etxmsol/ThermoShield/LoggerShieldDefect.jpg

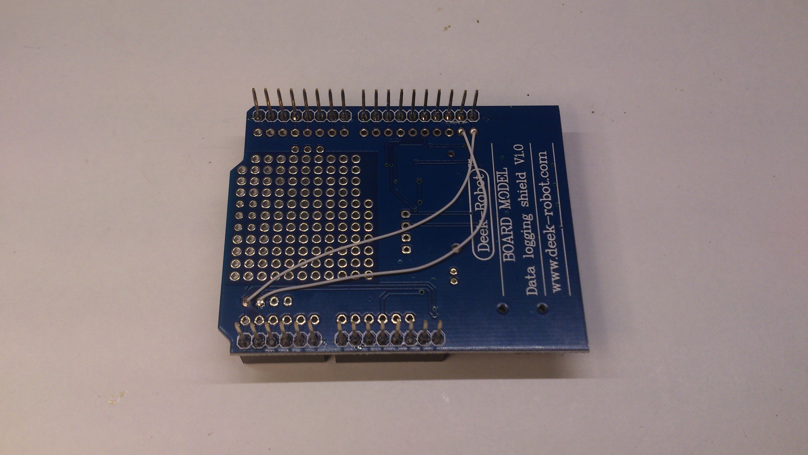
LoggerShieldDefect.jpg
