etxmsol/ThermoShield/conditioning.asc

C1: cap; 10nf
R3: res; 10k
U1: LT1013A
V1: voltage; 5
V2: voltage; ""; AC 10mv
V3: voltage; -5
Named nets: 0, +5, out, -5
;tran 1000
.ac dec 20 1Hz 1000KHz
