etxmsol/ThermoShield/Draft5.asc

R1: res; 10k
R2: res; 5k
U1: LT1022
V1: voltage; SINE(0 10mv 10k); AC 10mv; Rser=1meg Cpar=400pF
V2: voltage; -12
V3: voltage; +12
Named nets: 0, +Vdd, -Vcc, out
.tran 10ms
