etxmsol/ThermoShield/spice_simulation.asc

R1: res; {THERM}
R2: res; {r1}
V1: voltage; 5
Named nets: 0, opamp
.param THERM=100k*exp( 3950/(temp+273) - 3950/(25+273) )
.step temp -30 50 1
.op
.step param r1 list 5000 10000 100000 200000
