etxmsol/ThermoShield/v2.1/ThermoActuator.brd

## EAGLE design v2.1/ThermoActuator.brd (2016-06-04)

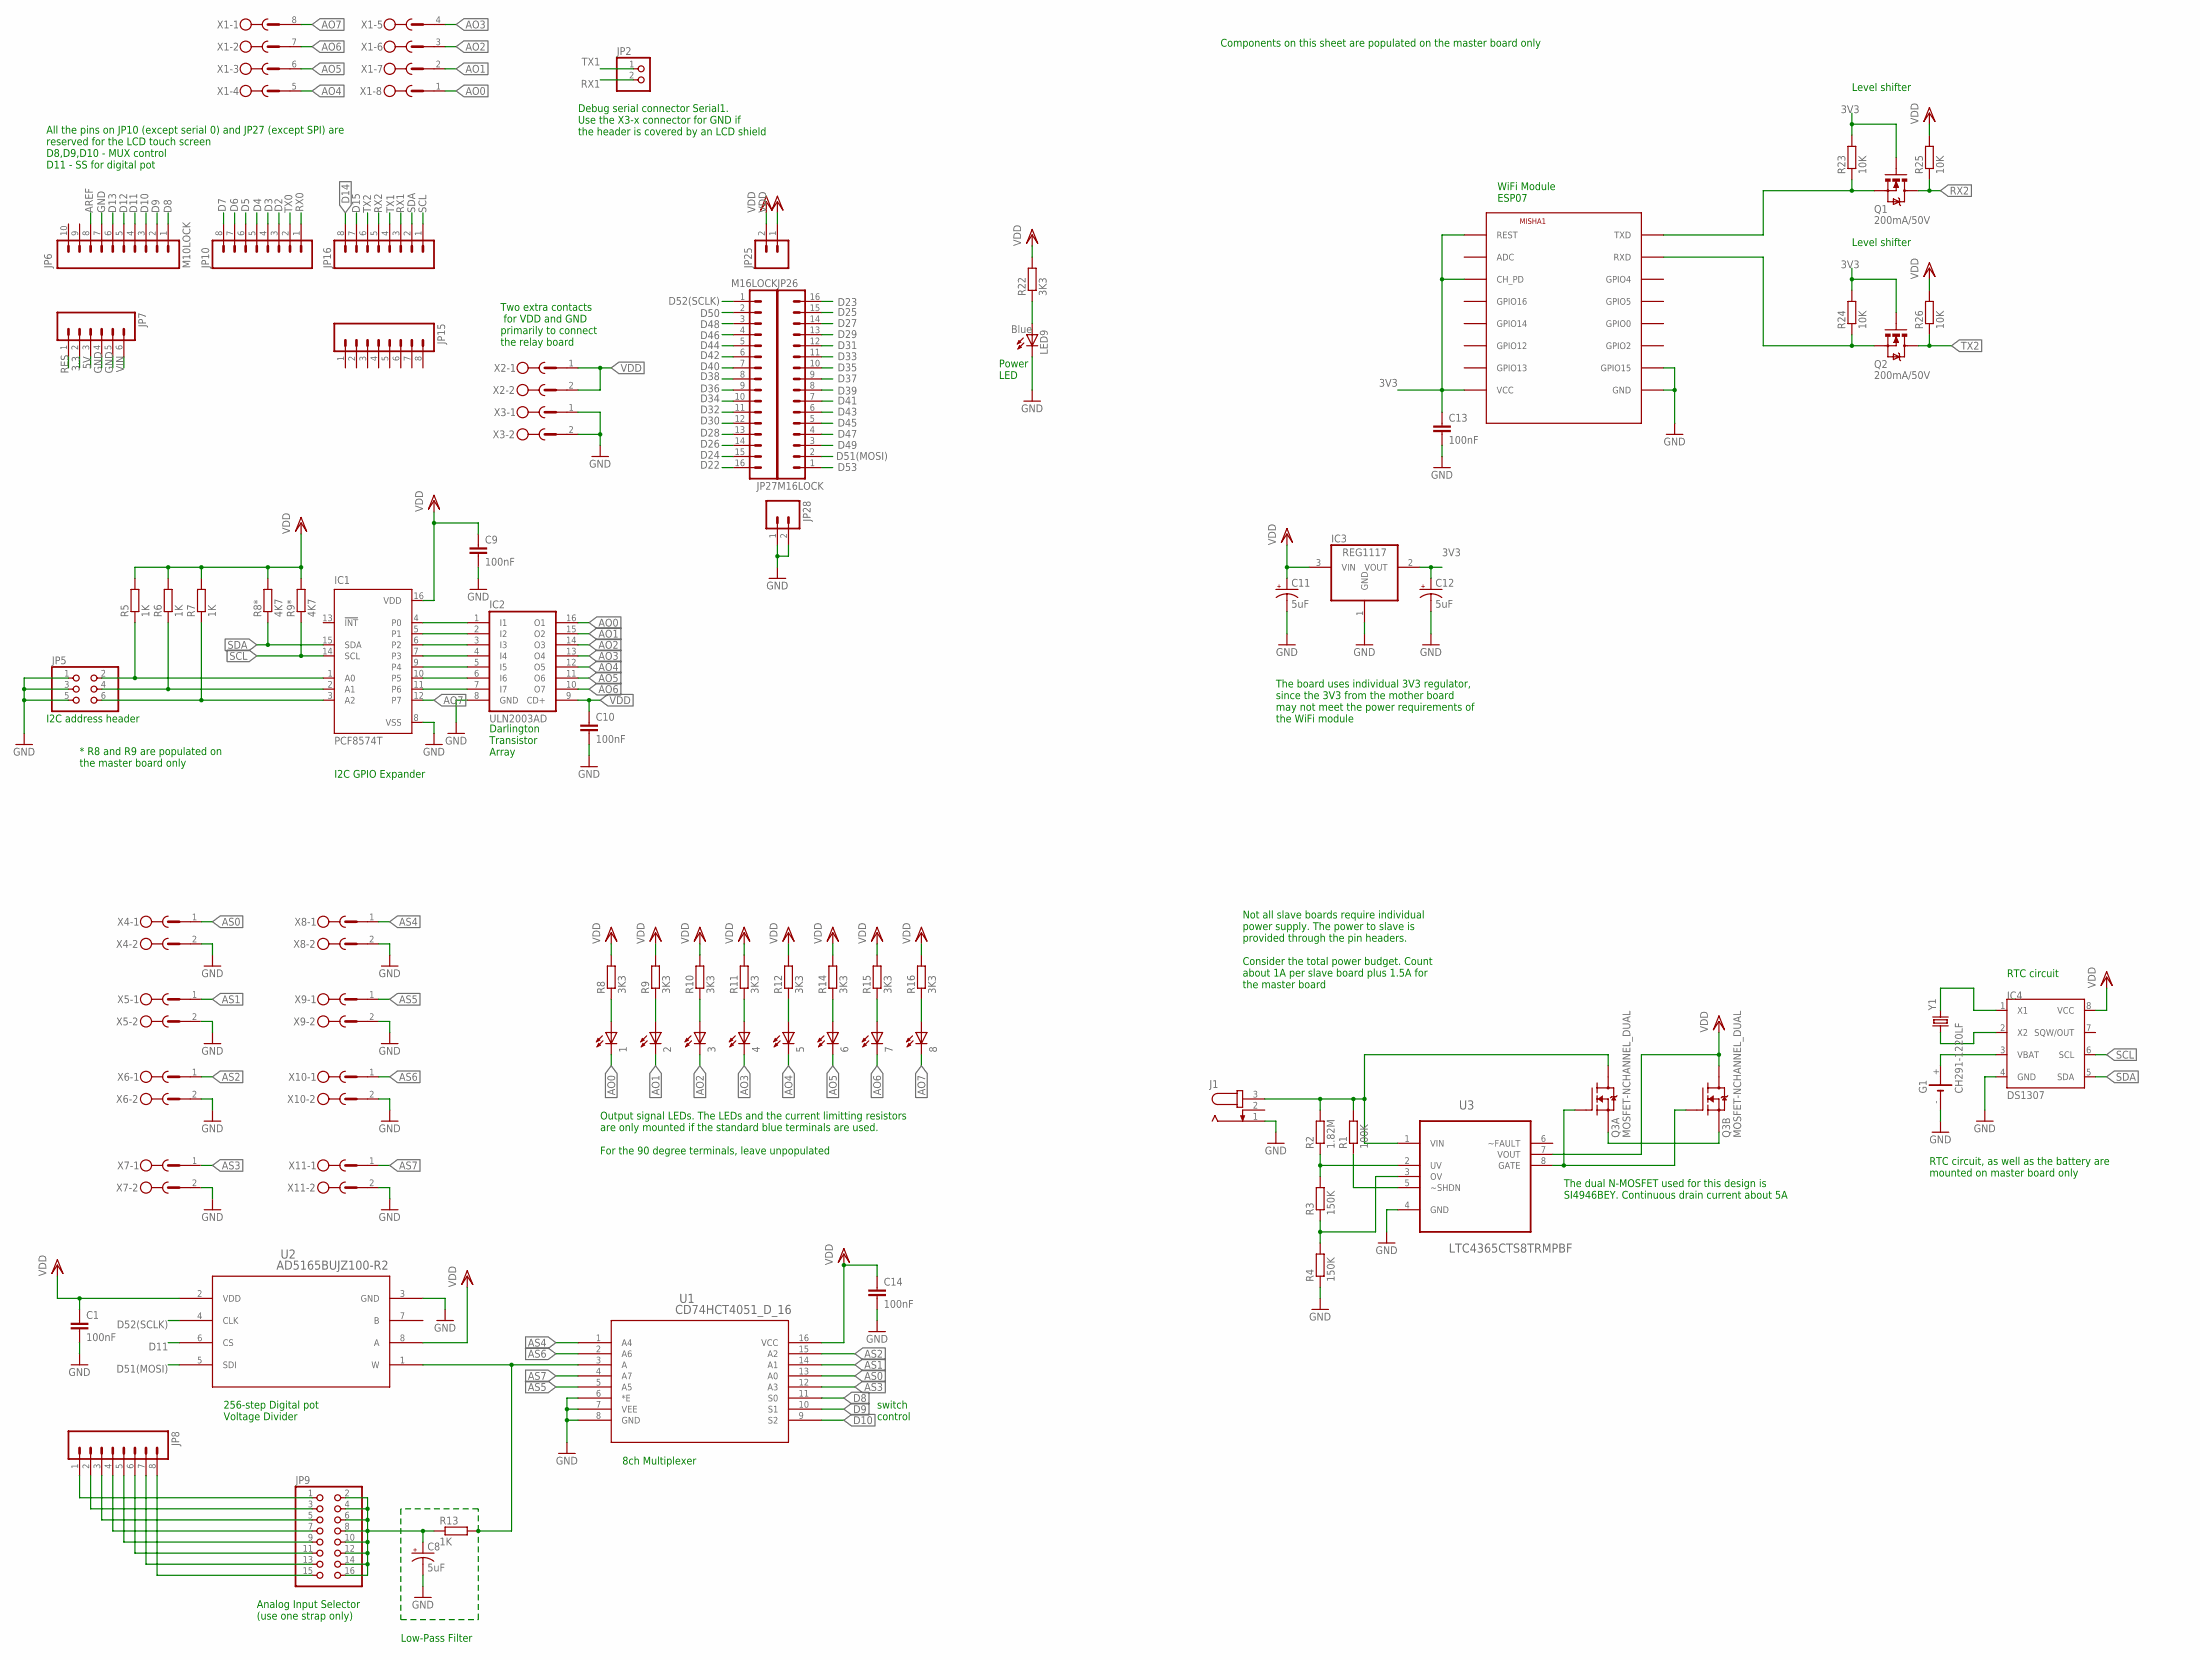
[picture p2: schematic ThermoActuator.sch]

Parts:
1, 2, 3, 4, 5, 6, 7, 8: LEDCHIP-LED0805; CHIP-LED0805
C1, C9, C10, C13, C14: 100nF; C0805
C8, C11, C12: 5uF; EIA3216
G1: CH291-1220LF
IC1: PCF8574T; SO16W
IC2: ULN2003AD; SO16
IC3: REG1117; SOT223
IC4: DS1307; SOIC-8
J1: JACK-PLUG1; SPC4078
JP2: PINHD-1X2; 1X02
JP5: PINHD-2X3; 2X03
JP6: M10LOCK; 1X10_LOCK
JP7: M06LOCK; 1X06_LOCK
JP8, JP10, JP15, JP16: M08LOCK; 1X08_LOCK
JP9: PINHD-2X8; 2X08
JP25, JP28: M02LOCK; 1X02_LOCK
JP26, JP27: M16LOCK; 1X16_LOCK
LED9: Blue; CHIP-LED0805
MISHA1: ESP8266-07; ESP-07
Q1, Q2: 200mA/50V; SOT23-3
Q3: MOSFET-NCHANNEL_DUAL; SO08
R1: 100K; R0805
R2: 1.82M; R0805
R3, R4: 150K; R0805
R5, R6, R7: 1K; R0805
R8, R9, R10, R11, R12, R14, R15, R16, R22: 3K3; R0805
R8*, R9*: 4K7; R0805
R13: 1K; R1206
R23, R24, R25, R26: 10K; R0805
U1: CD74HCT4051_D_16; D16
U2: AD5165BUJZ100-R2; UJ_8
U3: LTC4365CTS8TRMPBF; SOT65P280X100-8N
X1: MSTBV8
X2, X3, X4, X5, X6, X7, X8, X9, X10, X11: MSTBV2
Y1: CRYSTAL3.2X1.5MM; CRYSTAL-SMD-3.2X1.5MM

Connections:
3.3: JP7.2
3V3: C12.A (+), C13.1, IC3.2 (VOUT), MISHA1.CH_PD, MISHA1.REST, MISHA1.VCC, Q1.1 (G), Q2.1 (G), R23.2, R24.2
5V: JP7.3
AO0: 1.C, IC2.16 (O1), X1.1
AO1: 2.C, IC2.15 (O2), X1.2
AO2: 3.C, IC2.14 (O3), X1.3
AO3: 4.C, IC2.13 (O4), X1.4
AO4: 5.C, IC2.12 (O5), X1.5
AO5: 6.C, IC2.11 (O6), X1.6
AO6: 7.C, IC2.10 (O7), X1.7
AO7: 8.C, IC1.12 (P7), X1.8
AREF: JP6.8
AS0: U1.13 (A0), X4.1
AS1: U1.14 (A1), X5.1
AS2: U1.15 (A2), X6.1
AS3: U1.12 (A3), X7.1
AS4: U1.1 (A4), X8.1
AS5: U1.5 (A5), X9.1
AS6: U1.2 (A6), X10.1
AS7: U1.4 (A7), X11.1
D2: JP10.3
D3: JP10.4
D4: JP10.5
D5: JP10.6
D6: JP10.7
D7: JP10.8
D8: JP6.1, U1.11 (S0)
D9: JP6.2, U1.10 (S1)
D10: JP6.3, U1.9 (S2)
D11: JP6.4, U2.6 (CS)
D12: JP6.5
D13: JP6.6
D14: JP16.8
D15: JP16.7
D22: JP27.16
D23: JP26.16
D24: JP27.15
D25: JP26.15
D26: JP27.14
D27: JP26.14
D28: JP27.13
D29: JP26.13
D30: JP27.12
D31: JP26.12
D32: JP27.11
D33: JP26.11
D34: JP27.10
D35: JP26.10
D36: JP27.9
D37: JP26.9
D38: JP27.8
D39: JP26.8
D40: JP27.7
D41: JP26.7
D42: JP27.6
D43: JP26.6
D44: JP27.5
D45: JP26.5
D46: JP27.4
D47: JP26.4
D48: JP27.3
D49: JP26.3
D50: JP27.2
D51(MOSI): JP26.2, U2.5 (SDI)
D52(SCLK): JP27.1, U2.4 (CLK)
D53: JP26.1
GND: C1.2, C8.C (-), C9.2, C10.2, C11.C (-), C12.C (-), C13.2, C14.2, G1.-, IC1.8 (VSS), IC2.8 (GND), IC3.1 (GND), IC4.4 (GND), J1.1, JP5.1, JP5.3, JP5.5, JP6.7, JP7.4, JP7.5, JP28.1, JP28.2, LED9.C, MISHA1.GND, MISHA1.GPIO15, R4.1, U1.6 (*E), U1.7 (VEE), U1.8 (GND), U2.3 (GND), U3.4 (GND), X3.1, X3.2, X4.2, X5.2, X6.2, X7.2, X8.2, X9.2, X10.2, X11.2
unnamed: R1.1, U3.5 (~SHDN)
unnamed: R13.2, U1.3 (A), U2.1 (W)
unnamed: IC1.4 (P0), IC2.1 (I1)
unnamed: IC1.5 (P1), IC2.2 (I2)
unnamed: IC1.6 (P2), IC2.3 (I3)
unnamed: IC1.7 (P3), IC2.4 (I4)
unnamed: IC1.9 (P4), IC2.5 (I5)
unnamed: IC1.10 (P5), IC2.6 (I6)
unnamed: IC1.11 (P6), IC2.7 (I7)
unnamed: IC1.1 (A0), JP5.2, R5.1
unnamed: 1.A, R8.1
unnamed: R2.1, R3.2, U3.2 (UV)
unnamed: R3.1, R4.2, U3.3 (OV)
unnamed: Q3.2 (G), Q3.4 (G), U3.8 (GATE)
unnamed: Q3.1 (S), Q3.3 (S)
unnamed: IC4.1 (X1), Y1.P$2 (2)
unnamed: IC4.2 (X2), Y1.P$1 (1)
unnamed: G1.+, IC4.3 (VBAT)
unnamed: 2.A, R9.1
unnamed: IC1.2 (A1), JP5.4, R6.1
unnamed: IC1.3 (A2), JP5.6, R7.1
unnamed: JP8.1, JP9.1
unnamed: JP8.2, JP9.3
unnamed: JP8.3, JP9.5
unnamed: JP8.4, JP9.7
unnamed: JP8.5, JP9.9
unnamed: JP8.6, JP9.11
unnamed: 3.A, R10.1
unnamed: C8.A (+), JP9.2, JP9.4, JP9.6, JP9.8, JP9.10, JP9.12, JP9.14, JP9.16, R13.1
unnamed: JP8.7, JP9.13
unnamed: JP8.8, JP9.15
unnamed: MISHA1.TXD, Q1.2 (S), R23.1
unnamed: MISHA1.RXD, Q2.2 (S), R24.1
unnamed: J1.3, Q3.6 (D1), R1.2, R2.2, U3.1 (VIN)
unnamed: 4.A, R11.1
unnamed: 5.A, R12.1
unnamed: 6.A, R14.1
unnamed: 7.A, R15.1
unnamed: 8.A, R16.1
unnamed: LED9.A, R22.1
RES: JP7.1
RX0: JP10.1
RX1: JP2.2, JP16.3
RX2: JP16.5, Q1.3 (D), R25.1
SCL: IC1.14 (SCL), IC4.6 (SCL), JP16.1, R9*.1
SDA: IC1.15 (SDA), IC4.5 (SDA), JP16.2, R8*.1
TX0: JP10.2
TX1: JP2.1, JP16.4
TX2: JP16.6, Q2.3 (D), R26.1
VDD: C1.1, C9.1, C10.1, C11.A (+), C14.1, IC1.16 (VDD), IC2.9 (CD+), IC3.3 (VIN), IC4.8 (VCC), JP25.1, JP25.2, Q3.8 (D1), R5.2, R6.2, R7.2, R8.2, R8*.2, R9.2, R9*.2, R10.2, R11.2, R12.2, R14.2, R15.2, R16.2, R22.2, R25.2, R26.2, U1.16 (VCC), U2.2 (VDD), U2.8 (A), U3.7 (VOUT), X2.1, X2.2
VIN: JP7.6

Notes on the sheet:
I2C address header
I2C GPIO Expander
Darlington Transistor Array
8ch Multiplexer
Analog Input Selector (use one strap only)
switch control
Level shifter
WiFi Module ESP07
Power LED
The board uses individual 3V3 regulator, since the 3V3 from the mother board may not meet the power requirements of the WiFi module
Components on this sheet are populated on the master board only
* R8 and R9 are populated on the master board only
Not all slave boards require individual power supply. The power to slave is provided through the pin headers. Consider the total power budget. Count about 1A per slave board plus 1.5A for the master board
All the pins on JP10 (except serial 0) and JP27 (except SPI) are reserved for the LCD touch screen D8,D9,D10 - MUX control D11 - SS for digital pot
Low-Pass Filter
Two extra contacts for VDD and GND primarily to connect the relay board
256-step Digital pot Voltage Divider
RTC circuit
The dual N-MOSFET used for this design is SI4946BEY. Continuous drain current about 5A
Debug serial connector Serial1. Use the X3-x connector for GND if the header is covered by an LCD shield
Output signal LEDs. The LEDs and the current limitting resistors are only mounted if the standard blue terminals are used. For the 90 degree terminals, leave unpopulated
RTC circuit, as well as the battery are mounted on master board only

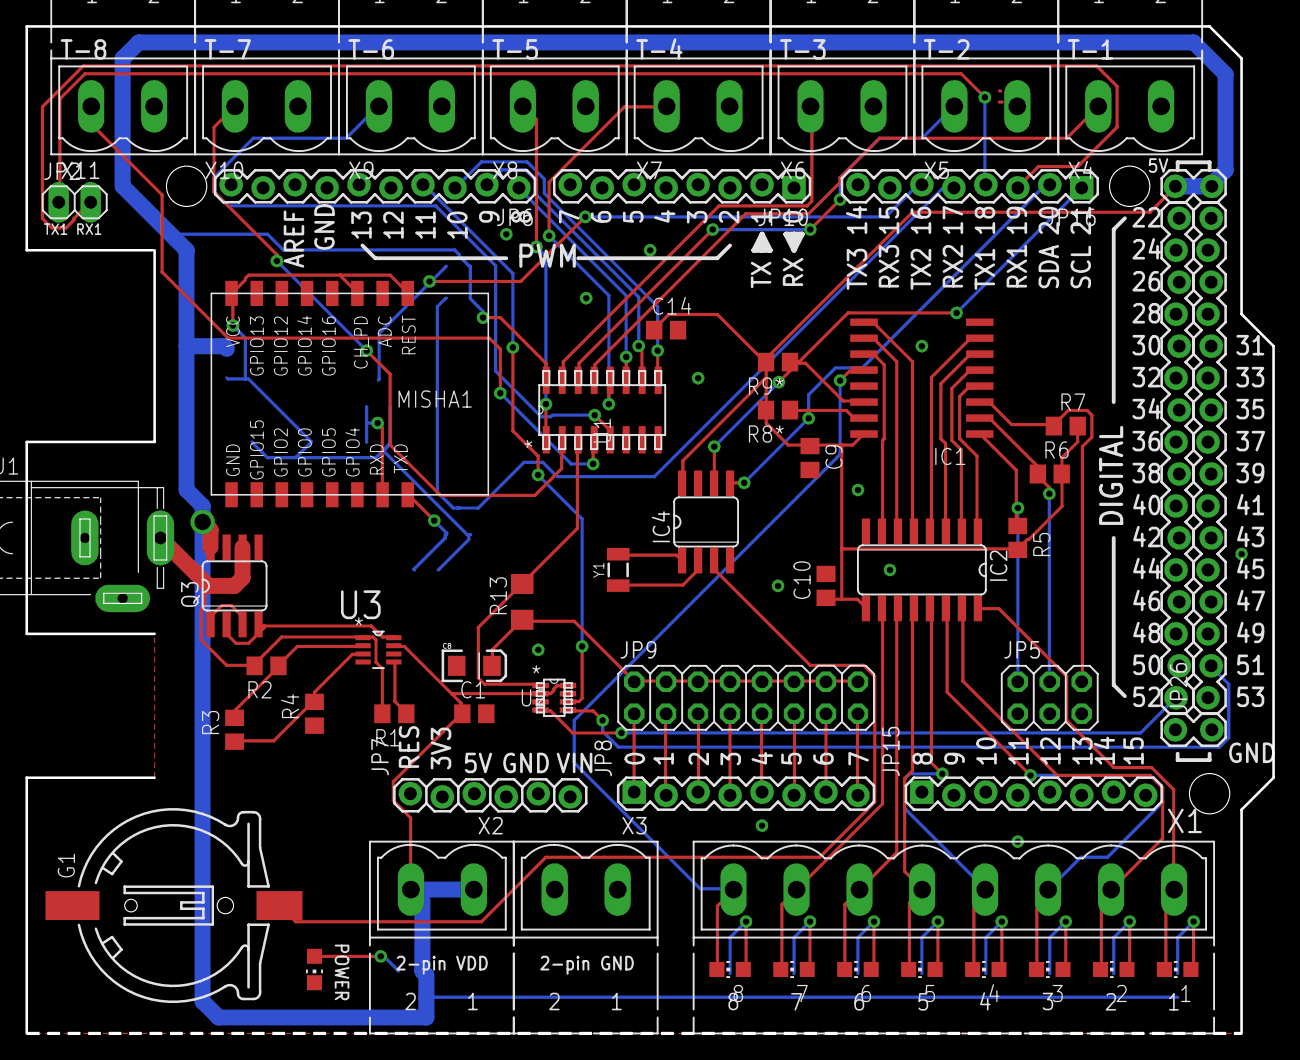
[picture p3: board ThermoActuator.brd from above]

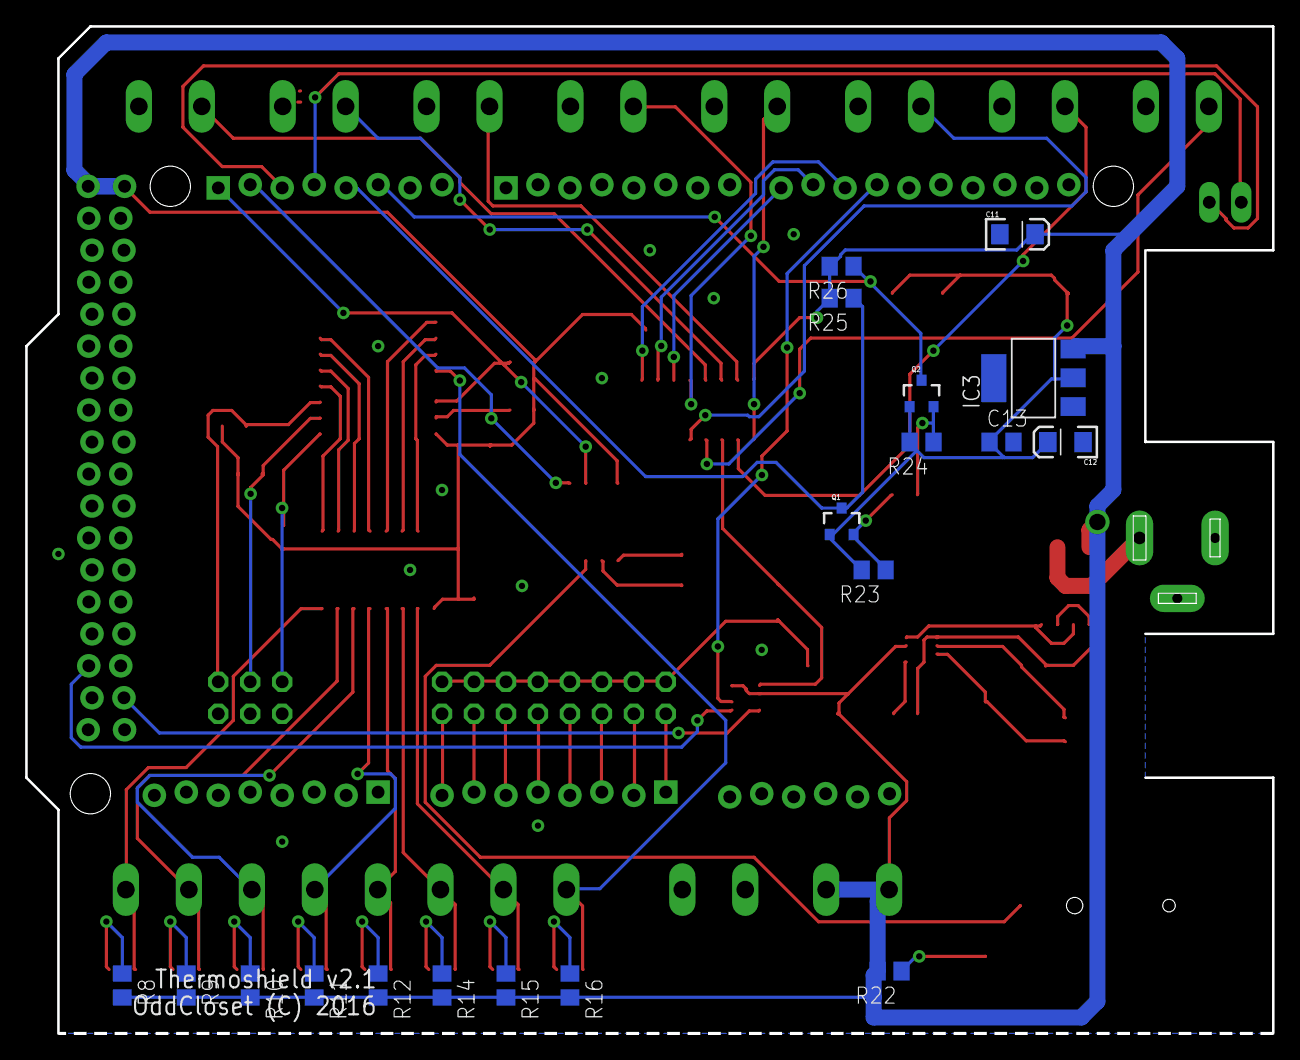
[picture p4: board ThermoActuator.brd from below]

Board: 2 copper layers, 99.1 x 80.0 mm, 78 parts (19 on the bottom side), 71 nets.
