etxmsol/ThermoShield/v1.0/ThermoActuator-v10.brd

## EAGLE design v1.0/ThermoActuator-v10.brd (2015-11-19, an earlier design)

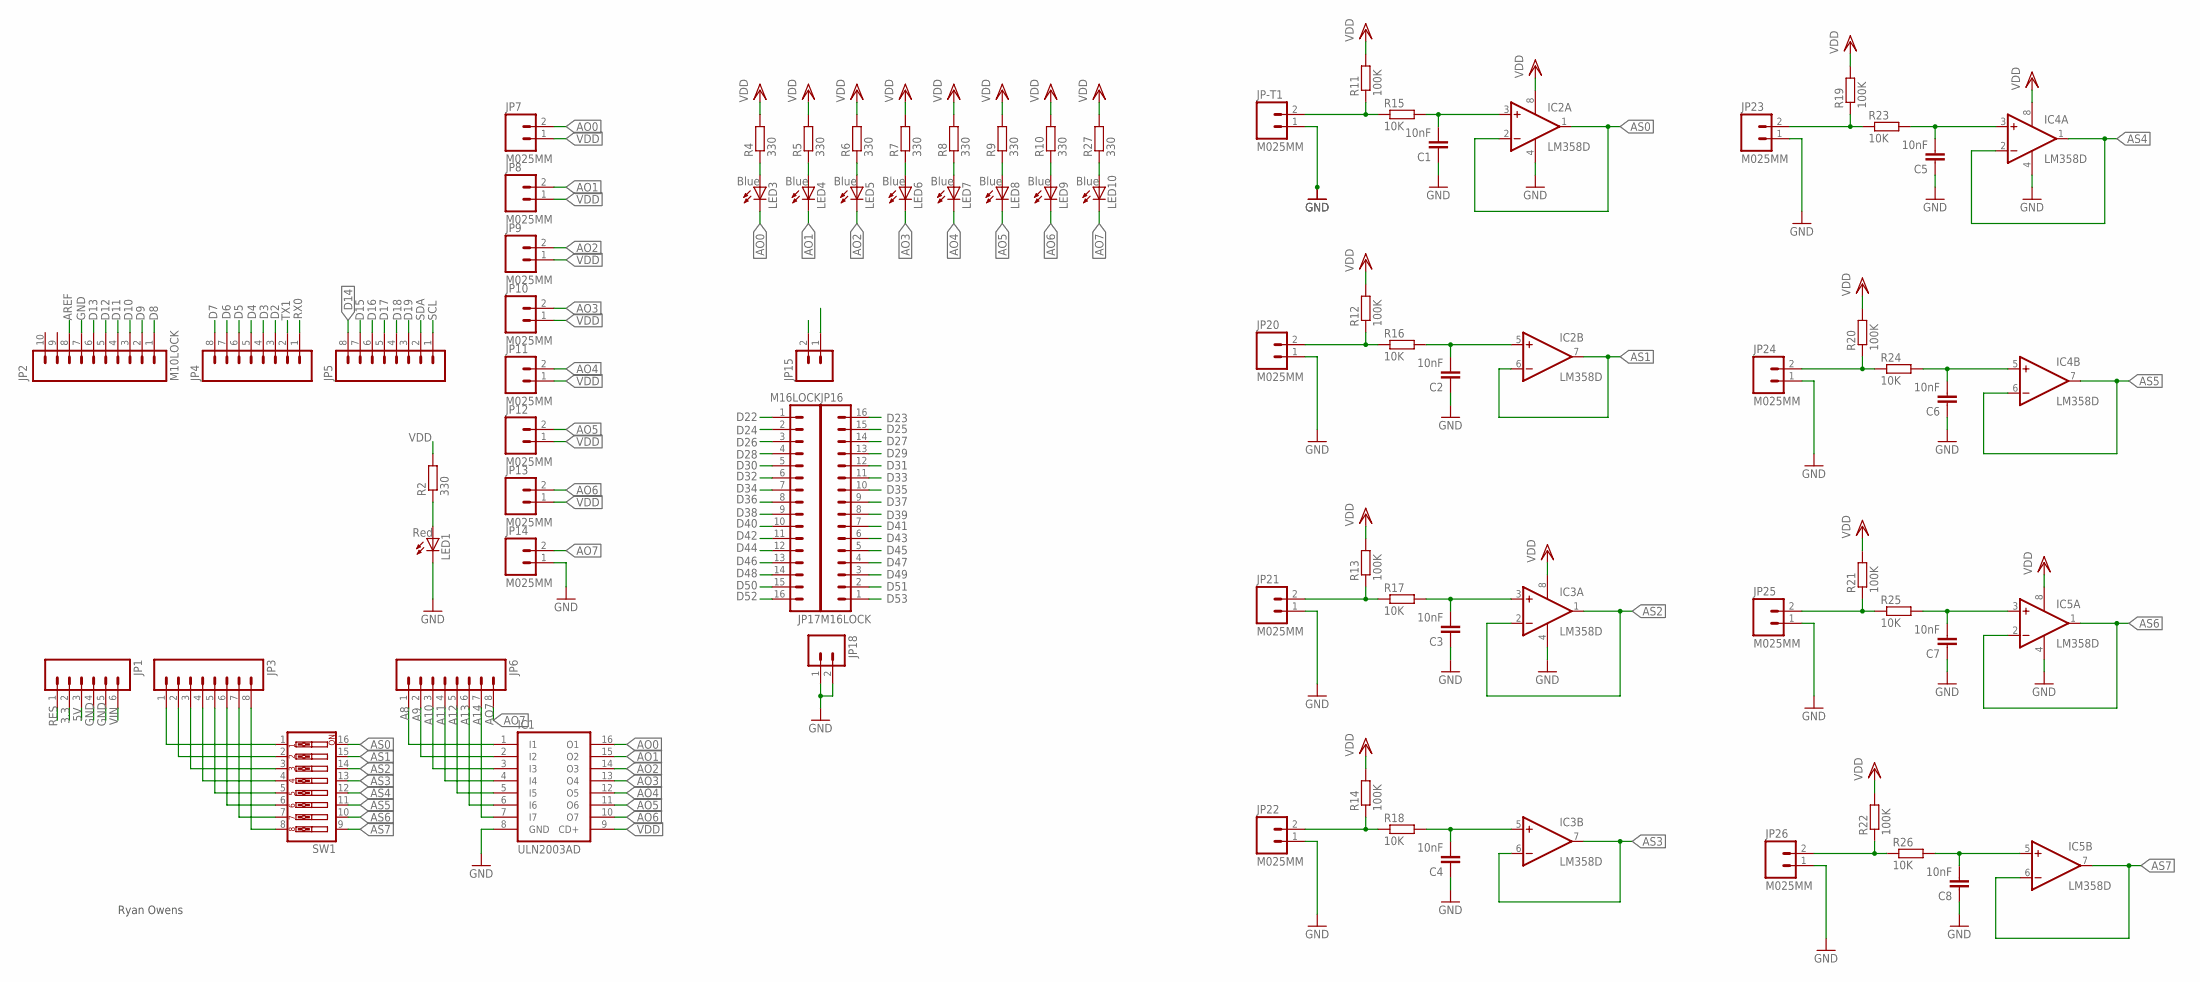
[picture p5: schematic ThermoActuator-v10.sch]

Parts:
C1, C2, C3, C4, C5, C6, C7, C8: 10nF; C1206
IC1: ULN2003AD; SO16
IC2, IC3, IC4, IC5: LM358D; SO08
JP1: M06LOCK; 1X06_LOCK
JP2: M10LOCK; 1X10_LOCK
JP3, JP4, JP5, JP6: M08LOCK; 1X08_LOCK
JP7, JP8, JP9, JP10, JP11, JP12, JP13, JP14, JP20, JP21, JP22, JP23, JP24, JP25, JP26: M025MM; SCREWTERMINAL-5MM-2
JP15, JP18: M02LOCK; 1X02_LOCK
JP16, JP17: M16LOCK; 1X16_LOCK
JP-T1: M025MM; SCREWTERMINAL-5MM-2
LED1: Red; CHIP-LED0805
LED3, LED4, LED5, LED6, LED7, LED8, LED9, LED10: Blue; CHIP-LED0805
R2, R4, R5, R6, R7, R8, R9, R10, R27: 330; R0805
R11, R12, R13, R14, R19, R20, R21, R22: 100K; R0805
R15, R16, R17, R18, R23, R24, R25, R26: 10K; R1206
SW1: SW_DIP-8; EDG-08

Connections:
3.3: JP1.2
5V: JP1.3
A8: IC1.1 (I1), JP6.1
A9: IC1.2 (I2), JP6.2
A10: IC1.3 (I3), JP6.3
A11: IC1.4 (I4), JP6.4
A12: IC1.5 (I5), JP6.5
A13: IC1.6 (I6), JP6.6
A14: IC1.7 (I7), JP6.7
AO0: IC1.16 (O1), JP7.2, LED3.C
AO1: IC1.15 (O2), JP8.2, LED4.C
AO2: IC1.14 (O3), JP9.2, LED5.C
AO3: IC1.13 (O4), JP10.2, LED6.C
AO4: IC1.12 (O5), JP11.2, LED7.C
AO5: IC1.11 (O6), JP12.2, LED8.C
AO6: IC1.10 (O7), JP13.2, LED9.C
AO7: JP6.8, JP14.2, LED10.C
AREF: JP2.8
AS0: IC2.1 (OUT), IC2.2 (-IN), SW1.16
AS1: IC2.6 (-IN), IC2.7 (OUT), SW1.15
AS2: IC3.1 (OUT), IC3.2 (-IN), SW1.14
AS3: IC3.6 (-IN), IC3.7 (OUT), SW1.13
AS4: IC4.1 (OUT), IC4.2 (-IN), SW1.12
AS5: IC4.6 (-IN), IC4.7 (OUT), SW1.11
AS6: IC5.1 (OUT), IC5.2 (-IN), SW1.10
AS7: IC5.6 (-IN), IC5.7 (OUT), SW1.9
D2: JP4.3
D3: JP4.4
D4: JP4.5
D5: JP4.6
D6: JP4.7
D7: JP4.8
D8: JP2.1
D9: JP2.2
D10: JP2.3
D11: JP2.4
D12: JP2.5
D13: JP2.6
D14: JP5.8
D15: JP5.7
D16: JP5.6
D17: JP5.5
D18: JP5.4
D19: JP5.3
D22: JP17.1
D23: JP16.16
D24: JP17.2
D25: JP16.15
D26: JP17.3
D27: JP16.14
D28: JP17.4
D29: JP16.13
D30: JP17.5
D31: JP16.12
D32: JP17.6
D33: JP16.11
D34: JP17.7
D35: JP16.10
D36: JP17.8
D37: JP16.9
D38: JP17.9
D39: JP16.8
D40: JP17.10
D41: JP16.7
D42: JP17.11
D43: JP16.6
D44: JP17.12
D45: JP16.5
D46: JP17.13
D47: JP16.4
D48: JP17.14
D49: JP16.3
D50: JP17.15
D51: JP16.2
D52: JP17.16
D53: JP16.1
GND: C1.1, C2.1, C3.1, C4.1, C5.1, C6.1, C7.1, C8.1, IC1.8 (GND), IC2.4 (V-), IC3.4 (V-), IC4.4 (V-), IC5.4 (V-), JP1.4, JP1.5, JP2.7, JP14.1, JP18.1, JP18.2, JP20.1, JP21.1, JP22.1, JP23.1, JP24.1, JP25.1, JP26.1, JP-T1.1, LED1.C
unnamed: JP-T1.2, R11.1, R15.1
unnamed: C1.2, IC2.3 (+IN), R15.2
unnamed: JP3.1, SW1.1
unnamed: JP3.2, SW1.2
unnamed: JP3.3, SW1.3
unnamed: JP3.4, SW1.4
unnamed: JP3.5, SW1.5
unnamed: JP3.6, SW1.6
unnamed: JP3.7, SW1.7
unnamed: JP3.8, SW1.8
unnamed: JP20.2, R12.1, R16.1
unnamed: C2.2, IC2.5 (+IN), R16.2
unnamed: LED3.A, R4.1
unnamed: LED4.A, R5.1
unnamed: LED5.A, R6.1
unnamed: LED6.A, R7.1
unnamed: LED7.A, R8.1
unnamed: LED8.A, R9.1
unnamed: LED9.A, R10.1
unnamed: JP21.2, R13.1, R17.1
unnamed: C3.2, IC3.3 (+IN), R17.2
unnamed: JP22.2, R14.1, R18.1
unnamed: C4.2, IC3.5 (+IN), R18.2
unnamed: JP23.2, R19.1, R23.1
unnamed: C5.2, IC4.3 (+IN), R23.2
unnamed: JP24.2, R20.1, R24.1
unnamed: C6.2, IC4.5 (+IN), R24.2
unnamed: JP25.2, R21.1, R25.1
unnamed: C7.2, IC5.3 (+IN), R25.2
unnamed: JP26.2, R22.1, R26.1
unnamed: C8.2, IC5.5 (+IN), R26.2
unnamed: LED10.A, R27.1
unnamed: LED1.A, R2.1
RES: JP1.1
RX0: JP4.1
SCL: JP5.1
SDA: JP5.2
TX1: JP4.2
VDD: IC1.9 (CD+), IC2.8 (V+), IC3.8 (V+), IC4.8 (V+), IC5.8 (V+), JP7.1, JP8.1, JP9.1, JP10.1, JP11.1, JP12.1, JP13.1, JP15.1, JP15.2, R2.2, R4.2, R5.2, R6.2, R7.2, R8.2, R9.2, R10.2, R11.2, R12.2, R13.2, R14.2, R19.2, R20.2, R21.2, R22.2, R27.2
VIN: JP1.6

Notes on the sheet:
Ryan Owens

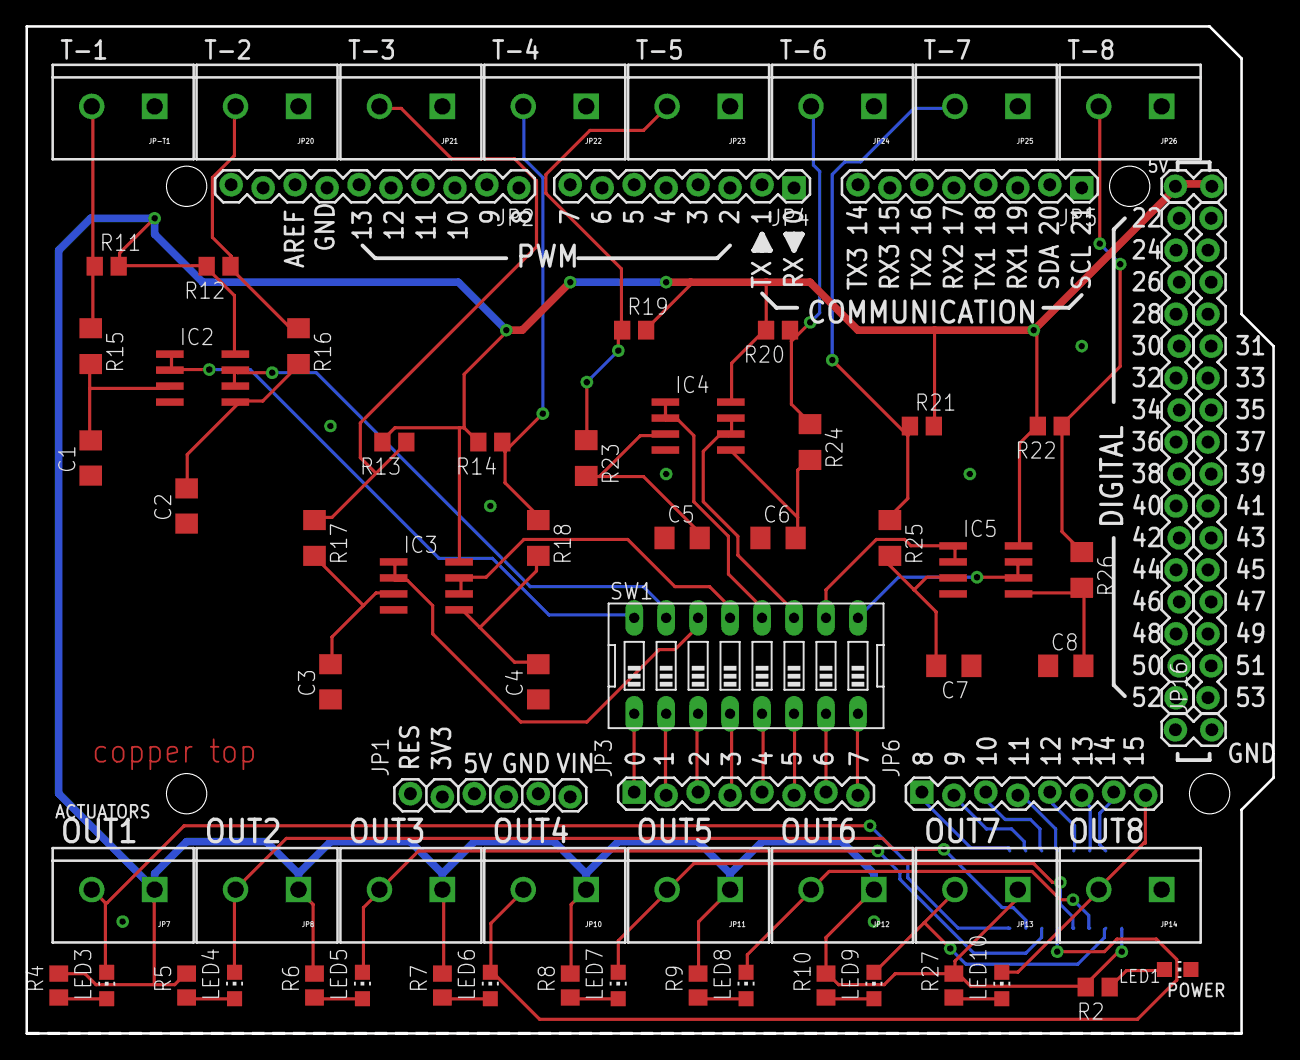
[picture p6: board ThermoActuator-v10.brd from above]

Board: 2 copper layers, 99.1 x 80.0 mm, 74 parts (1 on the bottom side), 58 nets.
