etxmsol/ThermoShield/(commit log)

2015-09-25 the base for the project
    [Mega_Shield-v13.brd, Mega_Shield-v13.sch]
2015-09-25 template shield
    [Empty_Shield-v13.brd, Empty_Shield-v13.sch, Empty_Shield_SMD-v13.brd, Empty_Shield_SMD-v13.sch]
2015-09-25 empty shield SMD
    [Empty_Shield-v13.brd, Empty_Shield-v13.sch, Empty_Shield_SMD-v13.brd, Empty_Shield_SMD-v13.sch]
2015-09-25 Empty MEGA SMD shield template
    [Empty_Shield_SMD-v13.brd]
2015-09-25 ThermoActuator shield created from the template
    [ThermoActuator-v10.brd, ThermoActuator-v10.sch]
2015-09-26 one thermistor ch laid out
    [ThermoActuator-v10.brd, ThermoActuator-v10.sch]
2015-09-26 two channels laid out
    [ThermoActuator-v10.brd, ThermoActuator-v10.sch]
2015-09-27 shield centered
    [ThermoActuator-v10.brd]
2015-09-27 centered with the right edge untouched
    [ThermoActuator-v10.brd, ThermoActuator-v10.sch]
2015-09-27 lower edge extended
    [ThermoActuator-v10.brd]
2015-10-05 4 ADC channels and 8 actuators
    somewhat messy, 20 vias. The sparkfun's recommended drc used
    [ThermoActuator-v10.brd, ThermoActuator-v10.sch]
2015-10-05 down to 126 DRC errors
    [ThermoActuator-v10.brd, ThermoActuator-v10.sch]
2015-10-06 all channels laid out
    somewhat inconsistent but all elements
    laid out except the button
    [ThermoActuator-v10.brd, ThermoActuator-v10.sch]
2015-10-07 local autorouting, no ripup *
    almost done. Removed the reset button. Will not be used
    on this shield (a higher shield will have it). Laying out
    VDD route. Only local auto-route from now on
    [ThermoActuator-v10.brd, ThermoActuator-v10.sch]
2015-10-08 relay power manual route
    this commit fixes one flipped connector, lines up
    the connectors on 0,1mm grid (as per Mega board)
    the board is almost ready for ordering
    [ThermoActuator-v10.brd, ThermoActuator-v10.sch]
2015-10-10 button removed. Ready for manufacturing
    the button is removed. It will sit on the top layer (RTC & SD shield)
    Screw terminals replace with pitch 5.
    Thermistor terminals moved to upper lane
    the board is ready for production, a request for quotation is sent
    [ThermoActuator-v10.brd, ThermoActuator-v10.sch]
2015-10-21 SW implementation: class Button
    [ThermoActuator-v10.brd]
2015-10-21 spice simulation for Thermistor
2015-11-02 fixed label alignment on OUTx
    [ThermoActuator-v10.brd]
2015-11-09 Documents stored
    the documents stored before paper copy go recycle. One bug is fixed. When
    no active channels are configured the program hangs at advance
    [storage.cpp, storage.h, thermoShield.cpp]
2015-11-11 The button class documented
2015-11-12 Introduced special handling for OUT7
    The 8th output for actuator is connected directly to the
    relay board, because ULN2003 has 7 channels only. This
    requires the invertion for this actuator channel
2015-11-16 bug fix for empty config.txt
    when an SD card inserted had no config.txt, an empty file
    is created, instead of the default config
    [storage.cpp]
2015-11-16 Alarm on storage.begin failure
    adding one alarm (LED) even on storage initialization failure.
    This can only occur on parsing error. More info should be
    obtained over the Serial1 (pin 18, 19)
    [thermoShield.cpp]
2015-11-19 Nasty routing error fixed
    The CH5 and CH6 did not work. That was because of one
    unobserved airwire. The ground was not routed to the IC4. Too bad
    On the boards the airwire must be mounted connecting the ground on C5
    with the pin 4 of the IC4
    The .brd is updated with one extra via, but because the boards are
    already manufactured, there is nothing that can be redone. Solder a
    wire...
    [ThermoActuator-v10.brd]
2016-01-17 calibration is added
    this version is for the 10K NTC thermistor. The board is
    populated with low-pass (tantalum) RC filter
2016-02-11 Start schematics of the v2.0
    [ThermoActuator.brd, ThermoActuator.sch]
2016-02-16 PCF8574 schematics ready
    schematics for the I2C GPIO expander is completed
    [ThermoActuator.brd, ThermoActuator.sch]
2016-02-18 8ch mux routing complete
    [ThermoActuator.brd, ThermoActuator.sch]
2016-02-21 PCB caped for lower profile
    two capes are cut. All components are thrown on the PCB
    [ThermoActuator.brd, ThermoActuator.sch]
2016-02-25 to the fab
    [ThermoActuator.brd, ThermoActuator.sch]
2016-05-03 ThermoShield v2.1
    a new version with WiFi support and cloud capabilities
    [ThermoActuator.brd, ThermoActuator.sch]
2016-05-04 routing complete, LEDs are back
    [ThermoActuator.brd, ThermoActuator.sch]
2016-06-04 digital pot ad5165
    better choice is a 4 or 6 channel POT. AD5204, AD5206.
    Available on eBay and can be serialized for higher values.
    Well, too late
    [ThermoActuator.brd]
2016-06-04 Digital Pot AD5165
    apart from the simple support for the digital POT, it was
    discovered that the double row header 38-pin was not correctly
    pin-mapped on the shield. This caused the SPI CLK would be
    connected to D22, instead of D52. Now, this is corrected, but...
    too late:)
    [ThermoActuator.brd, ThermoActuator.sch]
2016-06-13 switching digital POT
    not yet successful
2016-06-16 web configure R0 and Beta
    the item.php is extended to contain the parameters of
    the connected NTCs. The calibration value is also added to
    the web interface
